manatee-fluidics/Manatee/Build manuals/Controller/Controller build.pdf

# Manatee Controller Build Manual

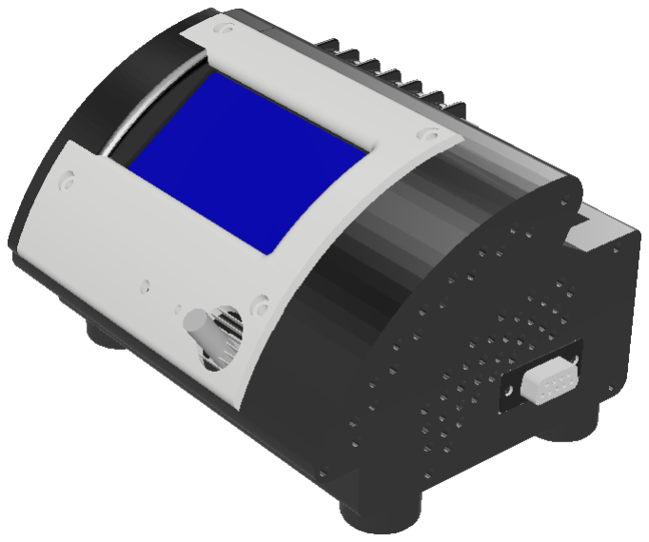
[picture p1: figure]

Csaba Konrad

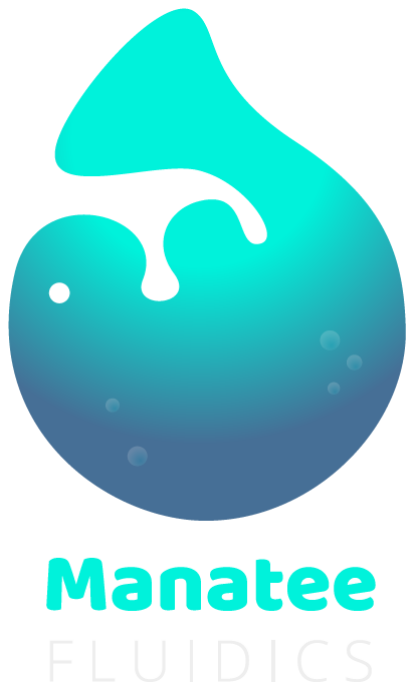
[picture p2: figure]

v1.0

# Tools

- Hex keys
- Soldering iron
- Crimping tools
- Ruler
- Phillips screwdriver

# Parts for 1-5 channels

- 3D printed:
- Body
- Cap
- Face
- Port seal (for each unused channel)
- Electronics:
- Arduino Mega R3
- Ramps 1.4
- Intelligent Digital LCD
12864 Display
- SilentStep TMC2100 (one
per channel)
- 40mm fan
- 25mm fan x2
- Power switch
- GST120A12-R7B power
supply
- Cables, connectors
- 9pin D-sub female (one + one per channel)
- Power connector
- Flat connector x2
- 6 pin terminal block
- 9 chribbon cable (8cm +
15cm for each channel)
- power cable (76 cm total)
- USB cable
- Screws, nuts
- D-sub nut (2 + 2 for each channel)
- M3x16mm x4
- M3x20mm x2
- M3x25mm x4
- M3x16mm x2
- M2.5x12mm x2

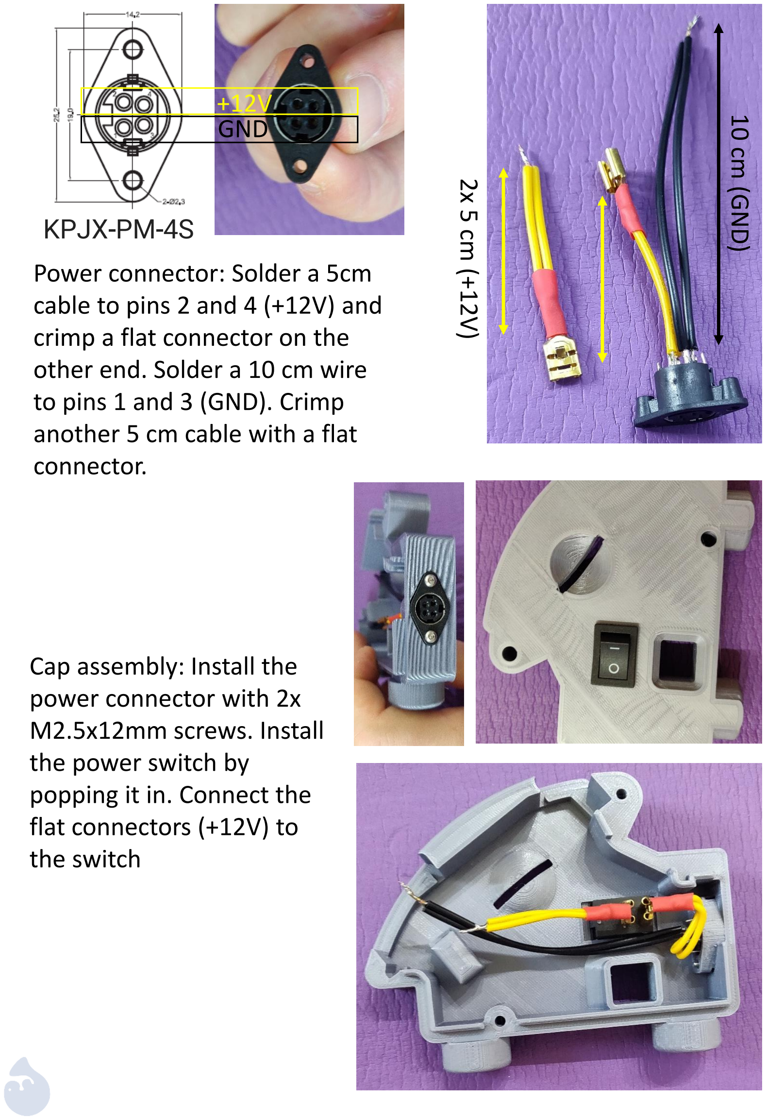
[picture p3: page 3]

KPJX

-PM

-4S
Power connector: Solder a 5cm cable to pins 2 and 4 (+12V) and crimp a flat connector on the other end. Solder a 10 cm wire to pins 1 and 3 (GND). Crimp another 5 cm cable with a flat connector.

2x 5 cm (+12V)

+12V
10 cm (GND)
GND

Cap assembly: Install the
power connector with 2x
M2.5x12mm screws. Install
the power switch by
popping it in. Connect the flat connectors (+12V) to
the switch

Channel connector
assembly: For each

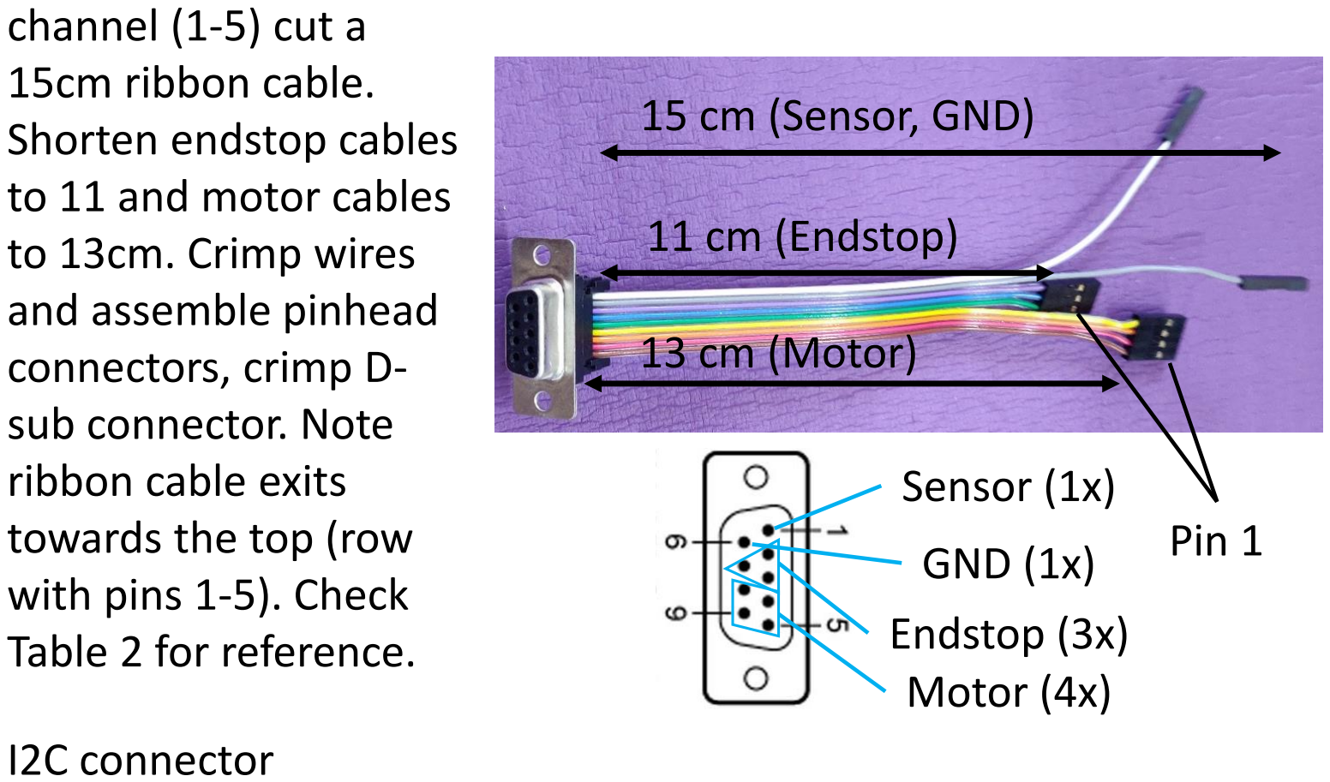
[picture p4: figure]
channel (1-5) cut a 15cm ribbon cable. Shorten endstop cables to 11 and motor cables to 13cm. Crimp wires and assemble pinhead connectors, crimp D- sub connector. Note ribbon cable exits towards the top (row with pins 1-5). Check Table 2 for reference.; Motor (4x); Endstop (3x); Sensor (1x); GND (1x); 15 cm (Sensor, GND); 11 cm (Endstop); 13 cm (Motor); I2C connector; Pin 1

assembly: cut a 8cm
piece of ribbon cabe.
Crimp it to a D-sub
connector. Note ribbon
cable exits towards the
bottom (row with pins
6-9). Cut two 13cm
cables for power,
solder them to pins
5+9 (GND) and 4+8
(+12V). Cut off cable
from pin 1. Crimp
cables from 2,3,6 and 7
and assemble pinhead
connector. Note the
order of the cables, see
Table 1 for reference.

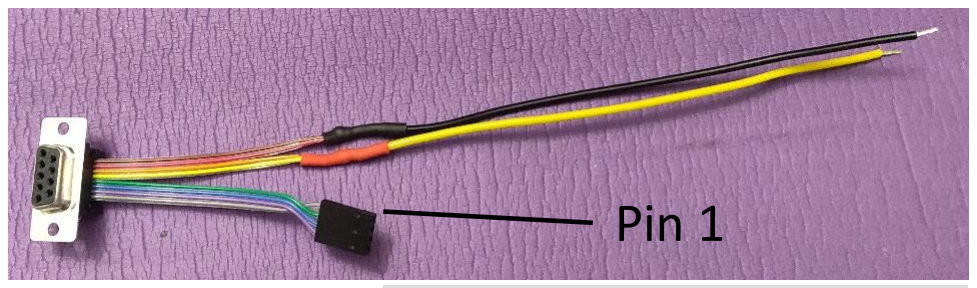
[picture p5: figure]
Pin 1
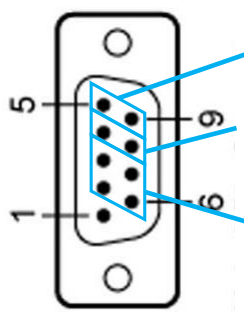
[picture p6: figure]

GND
+12V
I2C
female D-Sub | RAMPS connection | Pinhead
pin 1 | No connection
pin 6 | I2C 21 | Pin 1
pin 2 | I2C +5V | Pin 4
pin 7 | I2C GND | Pin 3
pin 3 | I2C 20 | Pin 2
pin 8 | Power +
pin 4
pin 9
pin 5

Power -
Table 1 I2C connector

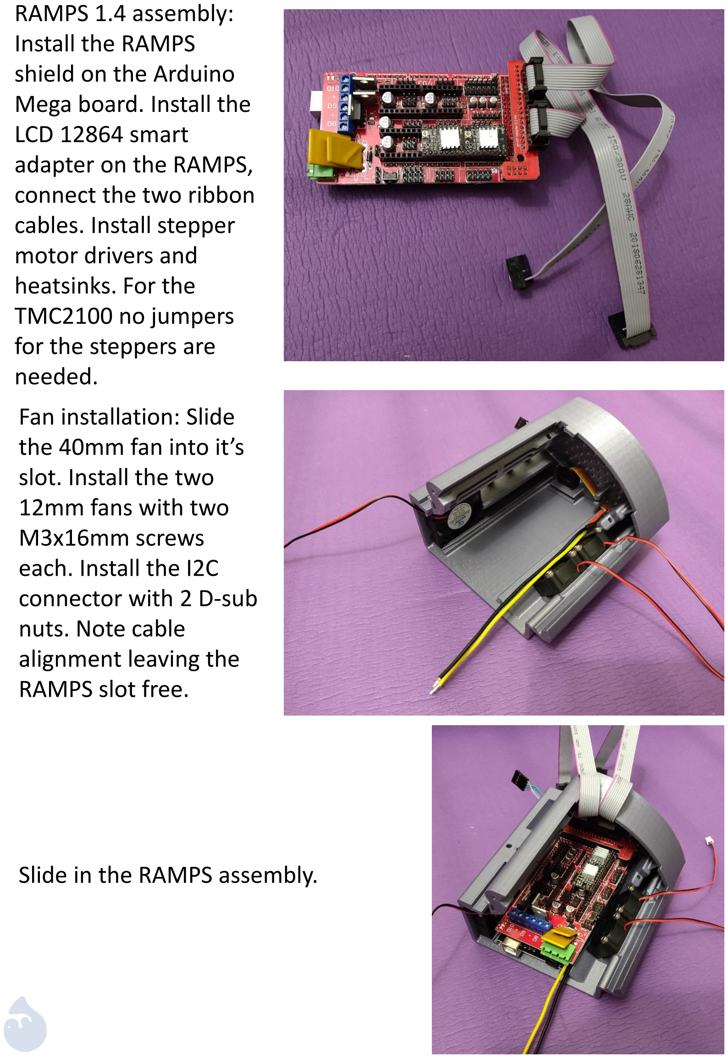
[picture p7: page 5]

RAMPS 1.4 assembly:
Install the RAMPS
shield on the Arduino
Mega board. Install the
LCD 12864 smart
adapter on the RAMPS,
connect the two ribbon
cables. Install stepper
motor drivers and
heatsinks. For the
TMC2100 no jumpers
for the steppers are
needed.
Fan installation: Slide
the 40mm fan into it’s
slot. Install the two
12mm fans with two
M3x16mm screws
each. Install the I2C
connector with 2 D-sub
nuts. Note cable
alignment leaving the
RAMPS slot free.

Slide in the RAMPS assembly.

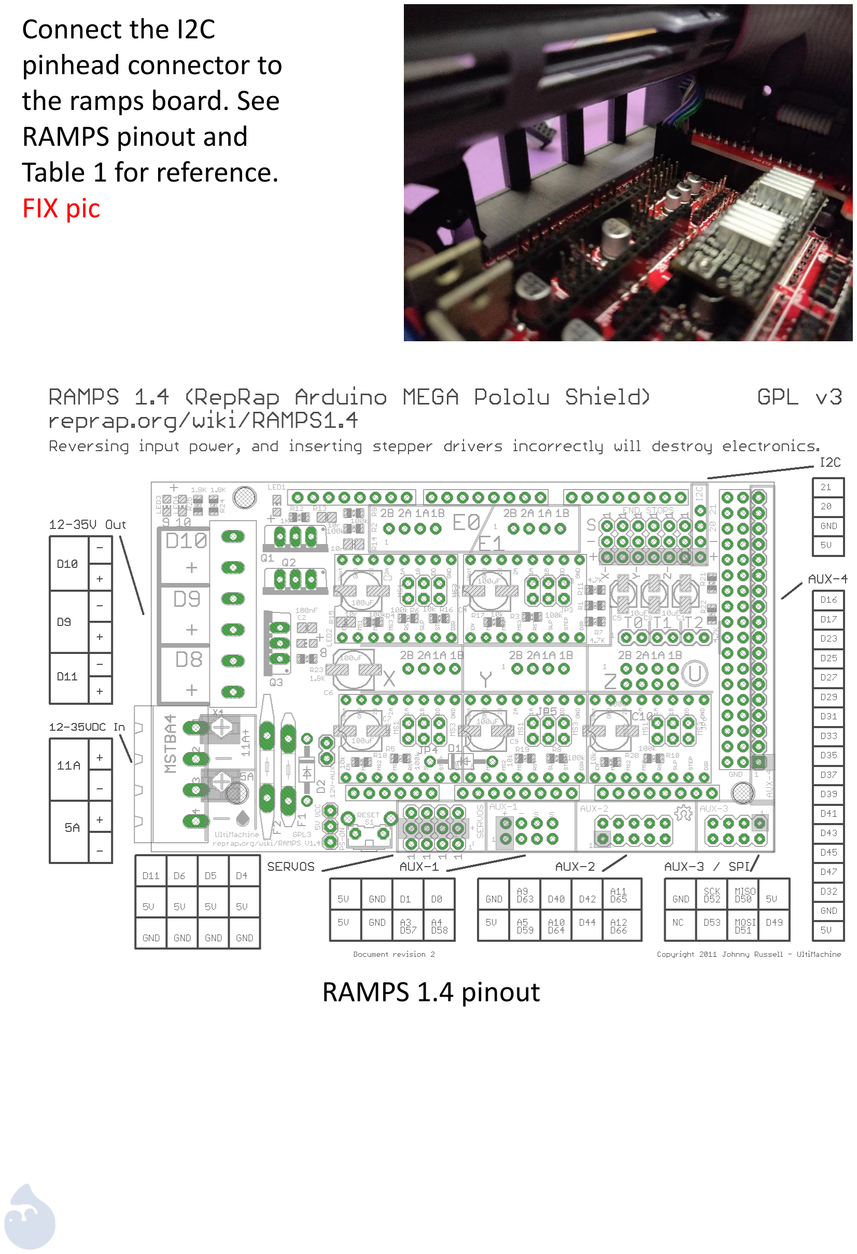
[picture p8: page 6]

Connect the I2C
pinhead connector to
the ramps board. See
RAMPS pinout and
Table 1 for reference.
FIX pic

RAMPS 1.4 pinout

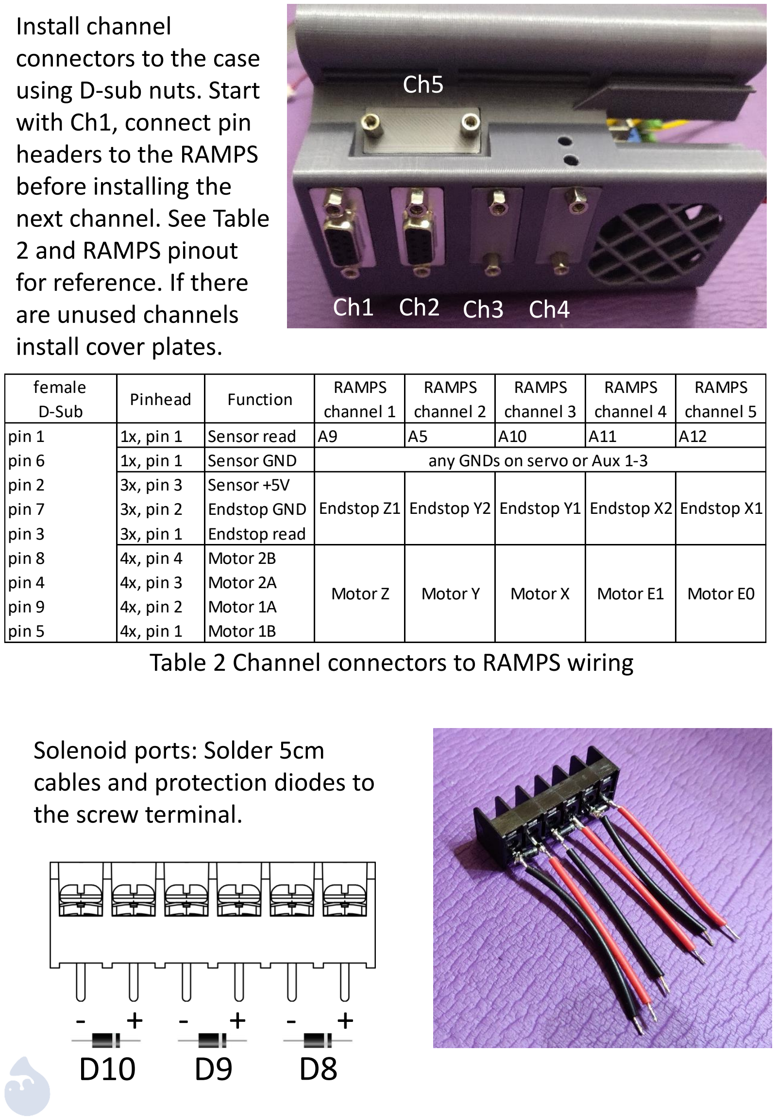
[picture p9: page 7]

Install channel
connectors to the case
using D-sub nuts. Start
with Ch1, connect pin
headers to the RAMPS
before installing the
next channel. See Table
2 and RAMPS pinout
for reference. If there
are unused channels
install cover plates.

Ch1 Ch2 Ch3 Ch4

Ch5

Table 2 Channel connectors to RAMPS wiring

Solenoid ports: Solder 5cm cables and protection diodes to the screw terminal.

- + - + - +
D10 | D9 | D8
female D-Sub | Pinhead | Function | RAMPS channel 1 | RAMPS channel 2 | RAMPS channel 3 | RAMPS channel 4 | RAMPS channel 5
pin 1 pin 6 pin 2 pin 7 pin 3 pin 8 pin 4 pin 9 pin 5 | 1x, pin 1 | Sensor read | A9 | A5 | A10 | A11 | A12
| 1x, pin 1 | Sensor GND | any GNDs on servo or Aux 1-3
| 3x, pin 3 3x, pin 2 3x, pin 1 | Sensor +5V Endstop GND Endstop read | Endstop Z1 | Endstop Y2 | Endstop Y1 | Endstop X2 | Endstop X1
| 4x, pin 4 4x, pin 3 4x, pin 2 4x, pin 1 | Motor 2B Motor 2A Motor 1A Motor 1B | Motor Z | Motor Y | Motor X | Motor E1 | Motor E0

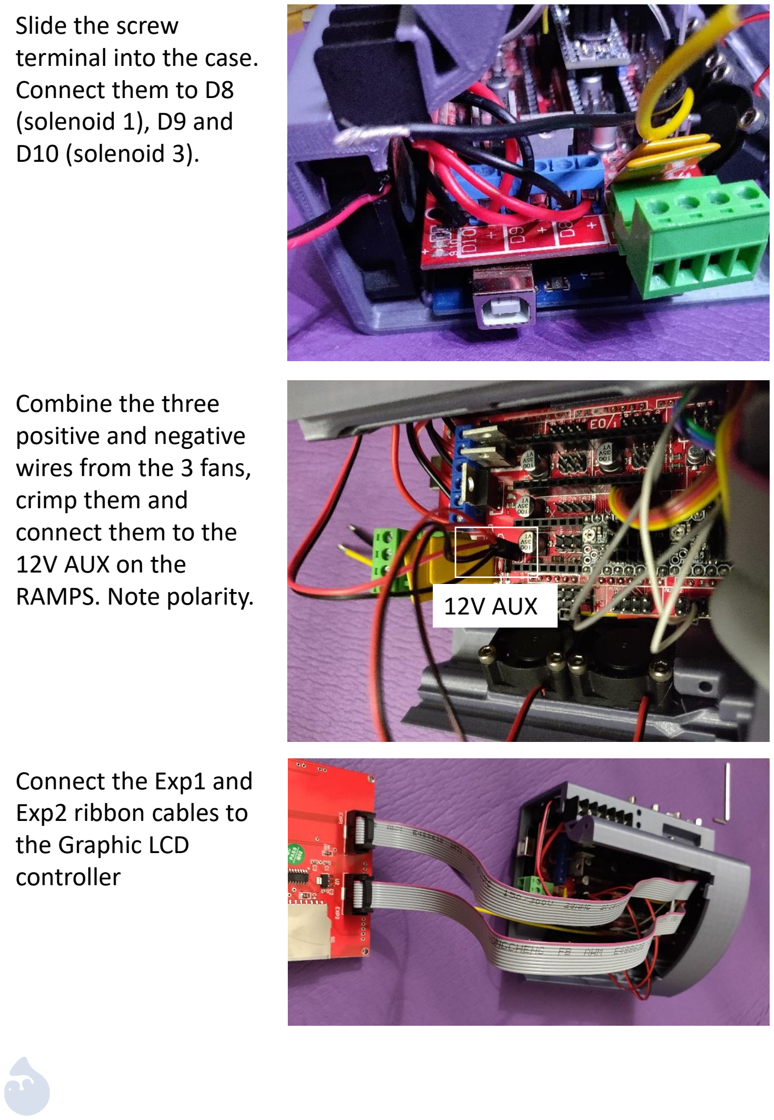
[picture p10: page 8]

Combine the three
positive and negative
wires from the 3 fans,
crimp them and
connect them to the
12V AUX on the
RAMPS. Note polarity.

Slide the screw
terminal into the case.
Connect them to D8
(solenoid 1), D9 and
D10 (solenoid 3).

Connect the Exp1 and
Exp2 ribbon cables to
the Graphic LCD
controller

12V AUX

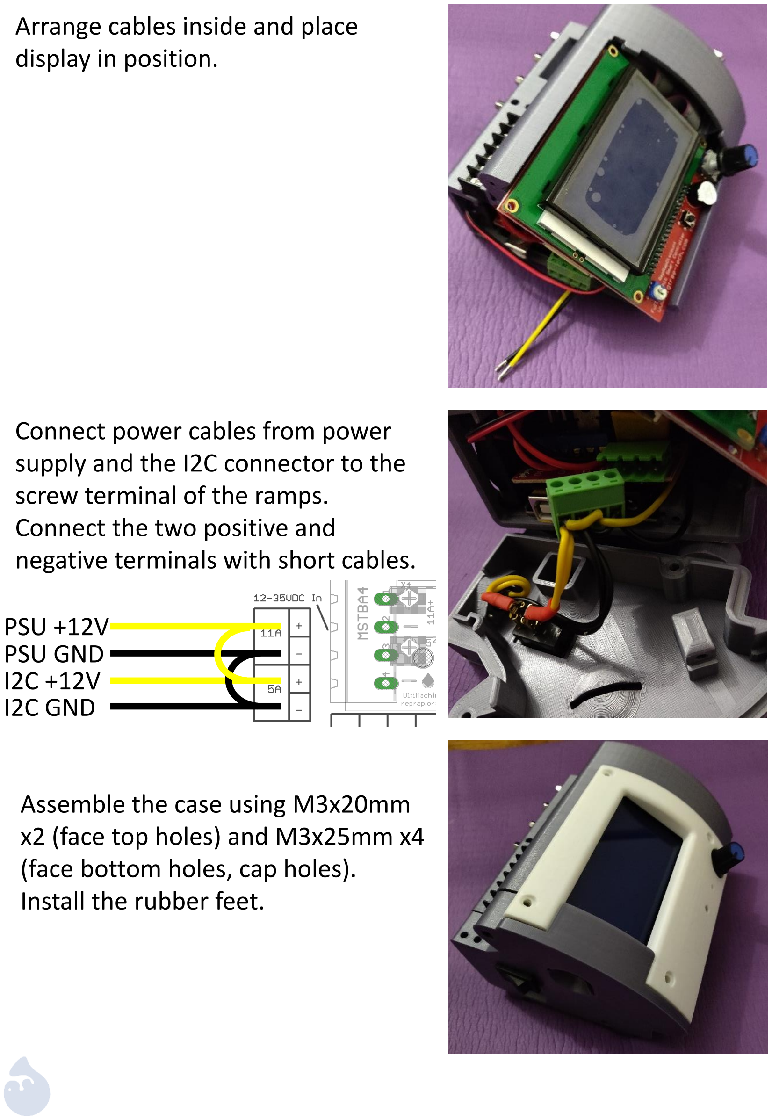
[picture p11: page 9]

Arrange cables inside and place display in position.

Connect power cables from power supply and the I2C connector to the screw terminal of the ramps. Connect the two positive and negative terminals with short cables.

PSU +12V
PSU GND
I2C +12V
I2C GND

Assemble the case using M3x20mm x2 (face top holes) and M3x25mm x4 (face bottom holes, cap holes). Install the rubber feet.

# Firmware installation

## 1. Download and install Arduino IDE: https://www.arduino.cc/en/main/ software (https://www.arduino.cc/en/main/software)

2. Connect controller via USB,

download and install driver for Arduino USB to serial chip if necessary (depends on clone) 3. Download eeprom flash and controller firmware from github: https://github.com/manatee-fluidics/Manatee/tree/master/Fir mware (https://github.com/csabak/Manatee/tree/master/Firmware) 4. Upload eepromflash to the controller, this will write the basic eeprom settings 5. Upload controller firmware to the controller
