manatee-fluidics/Manatee/(commit log)

2022-02-21 deleted refresh button
2022-02-28 pumps section of GUI 90% done
2022-02-28 slave buttons disabled
2022-03-05 connected to main window settings button
2022-03-05 opens from connection panel and settings button opens settings panel; other minor fixes
    [main_window.py]
2022-03-17 added scroll area to pump controls, refactoring
2022-03-17 added new input values, later will be used on pump controls
2022-03-17 layout and alignment fixes
    [main_window.py, main_window_controls.py, main_window_pumps.py, start_connection.py]
2022-03-18 process pump_settings dict and add values to corresponding textboxes
2022-03-26 settings panel generates new dict with settings data and closes, upon button click
2023-07-14 Alpha 0.1
    Finished GUI alpha version
    Added controller firmware and arduino code to populate eeprom for the first time
    Added controller build manual
